Bashitha07/Multi-Stage-Analog-Signal-Conditioner/AE Photos/Full circuit/1.jpeg

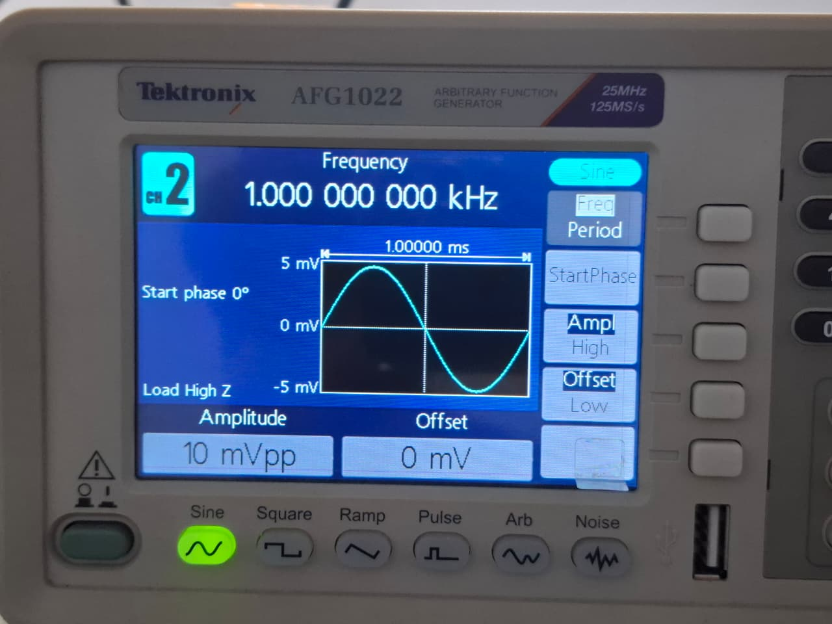
AE Photos/Full circuit/1.jpeg
