Bashitha07/Multi-Stage-Analog-Signal-Conditioner/README.md

# Multi-Stage Analog Signal Conditioner

Analog signal conditioning circuit designed to isolate a 2 kHz to 12 kHz audio passband and amplify weak signals using a BC547 NPN transistor amplifier stage.

## Overview

This project implements a multi-stage analog filter and amplifier to:
- Isolate an audio passband from 2 kHz to 12 kHz (bandpass filtering).
- Amplify low-level signals using a BC547 BJT amplifier stage.
- Validate the design using Proteus simulation files and measured results.

## Features

- Bandpass filtering to suppress low-frequency noise and high-frequency interference.
- BJT amplification stage (BC547) for signal gain.
- Proteus simulation project (.pdsprj) for circuit simulation and frequency response analysis.
- Project report with design calculations and circuit photos.

## Repository structure

```text
├── AE Photos/                                   # Circuit schematics and setup photos
├── AE_Final.pdsprj                              # Proteus design file (simulation project)
├── Group No. 04 - AE - Final Assignment Report.pdf  # Detailed design & calculations report
└── README.md                                    # Project documentation
```

## 👥 Project Team

**Module:** IE2034 – Analog Electronics  
**Academic Year:** Year 2, Semester 2  
**Institution:** Sri Lanka Institute of Information Technology (SLIIT)  
**Group:** 04

| Student | Student ID |
|---|---|
| Sellapperuma B.A. | IT24103485 |
| Jayasinghe L.P. | IT24100888 |
