Bashitha07/Multi-Stage-Analog-Signal-Conditioner/Group No. 04 - AE - Final Assignment Report.pdf

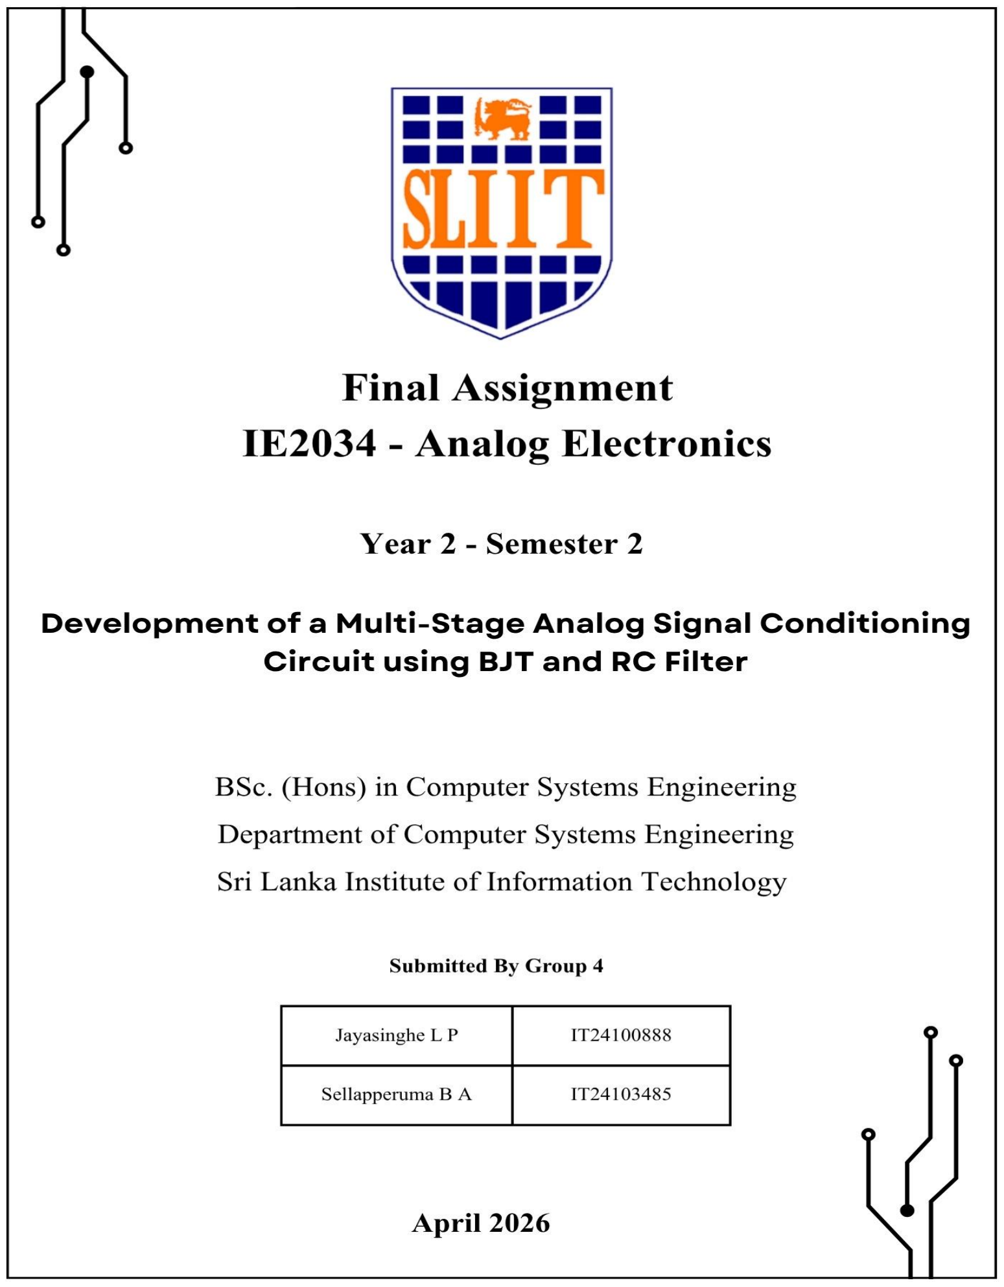
[picture p27: page 1]

## Contents

## 1. Objective

The objective of this assignment is to design and build a multi-stage analog signal conditioning circuit that works as a band-pass filter, only letting frequencies between 2kHz and 12kHz through. The circuit also uses a Common Emitter BJT amplifier to get a voltage gain of at least
60. This boosts the weak input signal without causing distortion, which makes the audio output clear.

## 2.Complete Circuit Design

The complete circuit, designed and simulated using Proteus, consists of three primary functional stages and an isolation stage connected in sequence:

- High-Pass Filter (HPF): Designed to allow signals above 2kHz to pass.
- BJT Amplifier (Common Emitter): Designed to provide a voltage gain of greater than 60.
- Low-Pass Filter (LPF): Configured to block signals to above 12kHz.

Circuit Flow and Stage Integration

The overall signal flows a direct sequence: HPF à BJT Amplifier à LPF.

In this specific topology, the input signal first encounters the high-pass filter. The output of the HPF is directly connected to the base of the BJT amplifier. Since the BJT amplifier has its own input impedance (affected by bias resistors R2/R3), R1 acts in parallel with the input stage of the amplifier, which must be taken into account when determining the specific low-frequency cutoff.

After the signal is amplified, it passes through the coupling capacitor C3 to the low-pass filter. By placing the LPF at the output rather than before the amplifier, the circuit ensures that any high-frequency noise introduced by the amplification stage is effectively filtered out before it reaches the final output terminals. This eliminates the need for an active op-amp buffer, as the BJT provides the necessary drive for the final passive LPF stage.

Full Circuit Designed in Proteus:

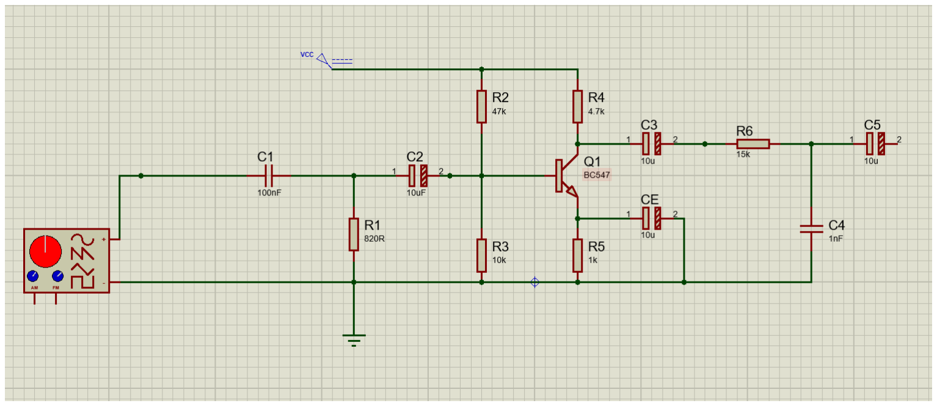
[picture p28: figure]

## 3.Theoretical Calculations

This circuit is a three-stage analog signal conditioning system designed for the audio output section of a basic AM radio. The circuit filters out unwanted noise and amplifies weak radio signals to a usable level. The three stages are:

3.1 Stage 1: High-Pass RC Filter (Cutoff Frequency = 2kHz)

3.2 Stage 2: Common Emitter BJT Amplifier (Voltage Gain >= 60)

3.3 Stage 3: Low-Pass RC Filter (Cutoff Frequency = 12kHz)

## 3.1 Stage 1: High-Pass Filter

A high-pass RC filter lets frequencies above the cutoff frequency through and blocks frequencies below it. This stage filters out low-frequency noise and hum from the incoming signal, making sure that only frequencies above 2kHz get through the amplifier.

The cutoff frequency formula for an RC filter is:

Fc = 1 / (2π * R* C)

Where: Fc = cutoff frequency (Hz), R = resistance(Ω), C = capacitance(F)

Design Calculation

Given Fc=2kHz. Choose C = 100 nF (a common, readily available value). Rearrange the formula to find R:

R = 1 / (2π * Fc * C)

R = 1 / (2π × 2000 × 100 × 10⁻⁹)

R = 1 / (2π × 2000 × 0.0000001)

R = 1 / (0.0001257)

R = 795 Ω

Use nearest standard value: R = 820 Ω

Verification

Fc = 1 / (2π × 820 × 100 × 10⁻⁹)

Fc = 1 / (2π × 820 × 100 × 10⁻⁹)

Fc = 1 / (0.000515)

Fc = 1.941 kHz ≈ 2 kHz ✓

Verified: Actual cutoff = 1940 Hz ≈ 2kHz (Within acceptable tolerance)

Component Selection

Component | Value / Part
C1 – HPF Capacitor | 100 nF Capacitor
R1 – HPF Resistor | 820 Ω
Filter Type | First-order passive RC high-pass filter

## 3.2 Stage 2: Common Emitter BJT Amplifier

Design Objective

The amplifier stage uses a BC547 NPN BJT in the Common Emitter (CE) configuration. It must achieve a mid-band voltage gain of at least 60 from a 9V DC supply. Voltage divider biasing is used to ensure a stable Q-point in the active region, independent of transistor beta (hFE) variations.

Transistor Parameters (BC547)

- VBE(on) = 0.7 V (typical for silicon NPN)
- hFE (beta) = approximately 100–400; design targets beta = 100 (worst case) for stability
- Operating region: active (linear amplification)
- Collector current IC = 1 mA (chosen for low power, stable operation)

Collector and Emitter Resistor Calculation

Collector Resistor R4

For maximum output voltage swing, the collector voltage VC should be approximately half of VCC:

VC = VCC / 2 = 9 / 2 = 4.5 V

IC × R4 = VCC - VC
R4 = (VCC - VC) / IC = (9 - 4.5) / 0.001 R4 = 4500 Ω --> use 4.7 kΩ

Emitter Resistor R5

The emitter resistor provides DC negative feedback for thermal stability. It is set to approximately VCC/10:

VE = VCC / 10 = 9 / 10 = 0.9 V

R5 = VE / IC = 0.9 / 0.001 = 900 Ω --> use 1 kΩ

Voltage Divider Biasing (R2 and R3)

The base voltage VB must be set to keep the transistor in the active region:

VB = VBE + VE = 0.7 + (IC × R5) = 0.7 + (0.001 × 1000) = 1.7 V

Voltage divider ratio:
VB / VCC = R3 / (R2 + R3)
1.7 / 9 = 0.1889

Choose R3 = 10 kΩ (standard value), solve for R2: R2 / R3 = (VCC / VB) - 1 = (9 / 1.7) - 1 = 4.294 R2 = 10000 × 4.294 = 42,941 Ω --> use 47 kΩ

Verification of Biasing

VB = VCC × R3 / (R2 + R3)
= 9 × 10000 / (47000 + 10000) = 9 × 0.1754 = 1.58 V

VE = VB - VBE = 1.58 - 0.7 = 0.88 V
IE ≈ IC = VE / R5 = 0.88 / 1000 = 0.88 mA (close to 1 mA target)

VC = VCC - (IC × R4) = 9 - (0.00088 × 4700) = 9 - 4.14 = 4.86 V
VCE = VC - VE = 4.86 - 0.88 = 3.98 V > 0.2V (active region confirmed)

Gain Calculation

Without Bypass Capacitor (AC gain)

The small-signal emitter resistance re is calculated first:

re = 26 mV / IC = 26 mV / 1 mA = 26 Ω

Av (without CE) = -RC / (re + RE)
= -4700 / (26 + 1000)
= -4700 / 1026
= -4.58 (|Av| = 4.58)

This is far below the required gain of 60. A bypass capacitor CE is essential.

With Bypass Capacitor CE (AC gain)

When a capacitor CE is placed in parallel with R5, it short-circuits R5 for AC signals. The AC gain then becomes:

Av (with CE) = -RC / re
= -4700 / 26
= -180.8

|Av| = 180.8 (Satisfies requirement of >= 60)

Bypass Capacitor CE Selection

CE must have a low reactance at the lowest signal frequency (2 kHz). The lower cutoff frequency introduced by CE is:

fL = 1 / (2π × CE × RE)

Choose CE = 10 µF:
fL = 1 / (2π × 10×10⁻⁶ × 1000) = 1 / (6.283 × 10⁻²)
= 15.9 Hz

fL = 15.9 Hz << 2 kHz (bypass is effective well below signal band)

Coupling Capacitors C2 and C3

10 µF coupling capacitors are used at the input and output of the amplifier to pass AC while blocking DC bias voltages from leaking into adjacent stages. The reactance of 10 µF at 2 kHz is:

XC2 = 1 / (2π × 2000 × 10×10⁻⁶)
= 1 / (0.1257)
= 7.96 ΩΩ << circuit impedances (negligible effect)

Amplifier Component Summary

Component | Value | Calculated | Purpose
R2 (bias top) | 47 kΩ | 42.9 kΩ | Sets VB via voltage divider
R3 (bias bottom) | 10 kΩ | 10 kΩ | Sets VB via voltage divider
R4 (collector) | 4.7 kΩ | 4.5 kΩ | Sets VC, determines gain
R5 (emitter) | 1 kΩ | 900 Ω | DC stability, thermal feedback
CE (bypass) | 10 µF | - | Boosts AC gain from 4.6 to 181
C2, C3 (coupling) | 10 µF each | - | Block DC between stages
Mid-band |Av| | ≈ 181 | Required: ≥ 60 | Satisfied with bypass capacitor

Design Justification

The voltage divider bias was chosen over the fixed bias, as it provides a stable Q-point that is largely independent of transistor hFE variations. The emitter resistor R5 adds DC negative feedback that further stabilizes the operating point against temperature changes. The bypass capacitor CE is the most critical component to achieve the required gain, without it, RE induces severe AC negative feedback, which reduces the gain to 4.6. With CE, the AC signal bypasses RE completely, and the gain rises to approximately 181, which is well above the required minimum of 60. This gives a good margin for real-world component tolerances.

## 3.3 Stage 3: Low Pass RC Filter

A low-pass RC filter lets through frequencies below the cutoff frequency and blocks frequencies above it. This stage blocks frequencies above it. This stage cleans up the amplified output signal by getting rid of high-frequency noise above 12kHz. This makes the audio output clear. The formula for the cutoff frequency is the same as for the high pass filter:

fc = 1 / (2π × R × C)

Given: fc = 12 kHz. Choose C = 1 nF (same as HPF for consistency).

Rearranging to find R:

R = 1 / (2π × fc × C)

R = 1 / (2π × 12000 × 1 × 10⁻⁹
)

R = 1 / (0.0000754)

R = 13,262.59 Ω (Use nearest standard value: R = 15 kΩ)

Verification

fc = 1 / (2π × 15000 × 1 × 10⁻⁹)

fc = 1 / (2π × 15000 × 10

-9
)

fc = 1 / (0.0000942)

fc = 10,610 Hz ≈ 12 kHz ✓

Verified: Actual cutoff = 10,610 Hz ≈ 11 kHz (Very close to 12 kHz, within tolerance)

Component Selection

Component | Value / Part
C4 – LPF Capacitor (shunt) | 1 nF ceramic disc capacitor
R6 – LPF Resistor (series) | 15 kΩ
C5 – Output coupling | 10 µF / 25 V electrolytic
Filter type | First – order passive RC low-pass filter

## 4.Complete Circuit Design on Dot Board

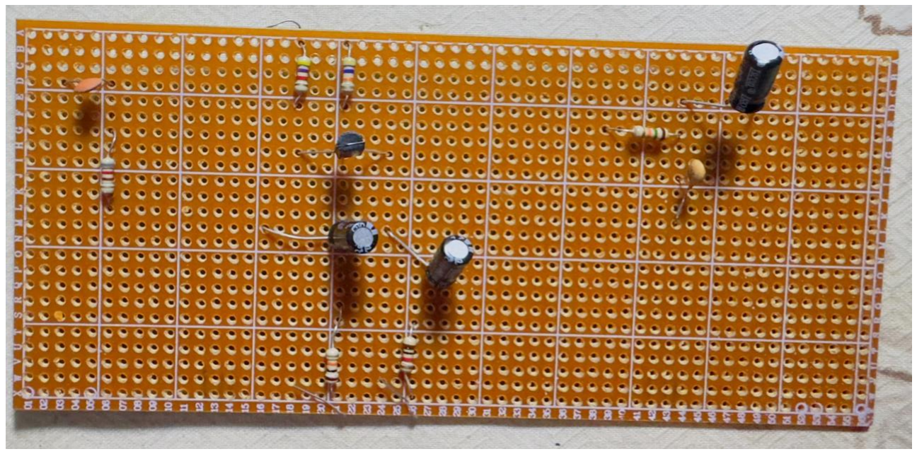
[picture p29: figure]

## 5. Output Waveforms & Observations

To systematically verify the design, the circuit was tested and observed in individual stages before evaluating the fully integrated system.

- High Pass Filter:
The initial stage was tested to verify its low frequency attenuation. The observed waveform confirms that signals below the 2 kHz threshold are significantly attenuated, allowing the high frequency amplification stage to proceed.
Circuit:

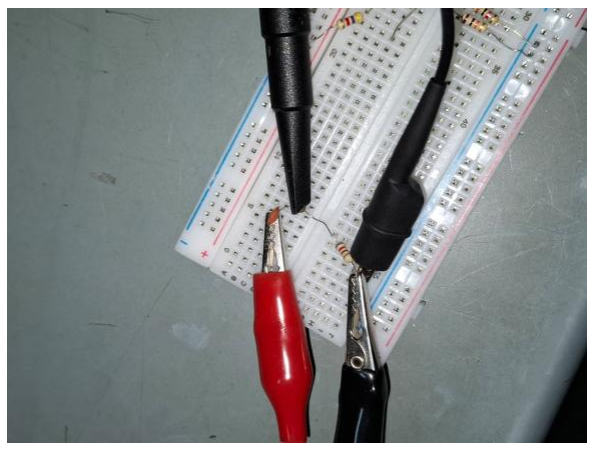
[picture p30: figure]

1kHz (<2kHz):

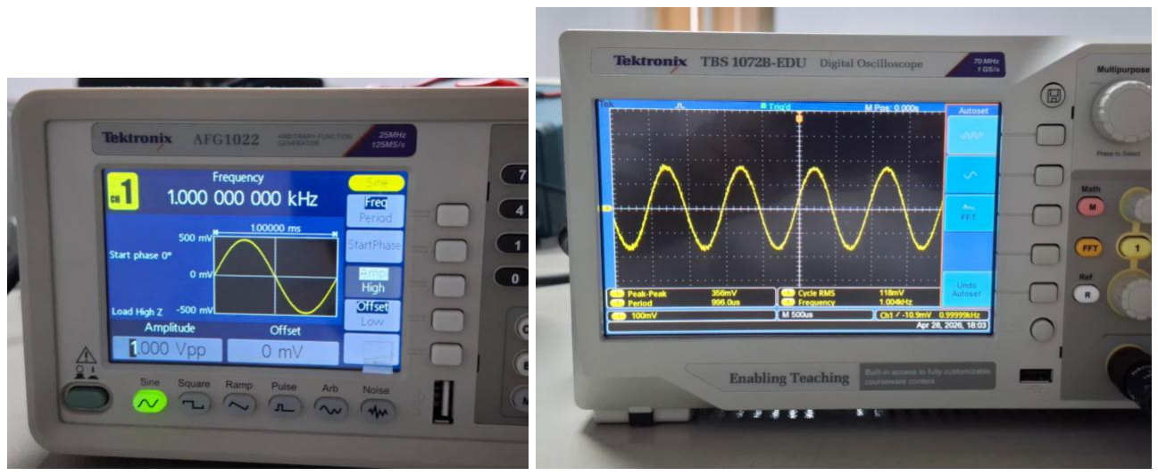
[picture p31: figure]

6kHz:

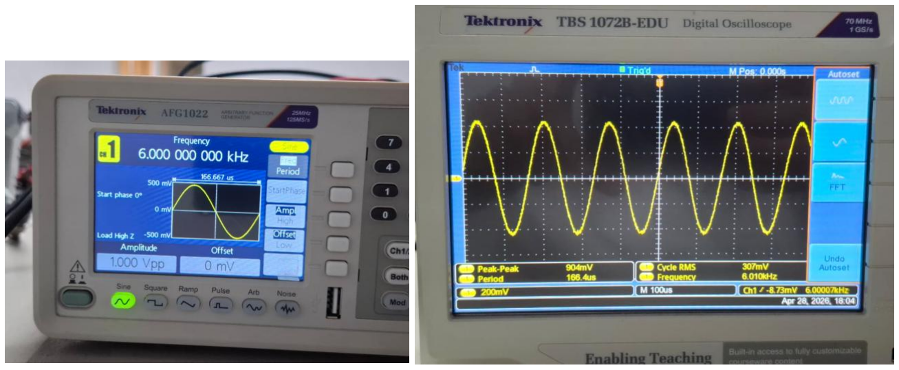
[picture p32: figure]

- BJT Amplifier:
The output was monitored directly from the collector of the BC547 transistor to verify the required voltage gain. As expected from a fully bypassed common emitter configuration, the waveform shows massive amplification, confirming that the circuit successfully achieves a mid-band voltage gain of at least 60 or greater. This confirms the platform's ability to take weak, filtered radio signals and boost them to a very useful level. Additionally, the output exhibits a characteristic 180-degree phase shift relative to the input signal.

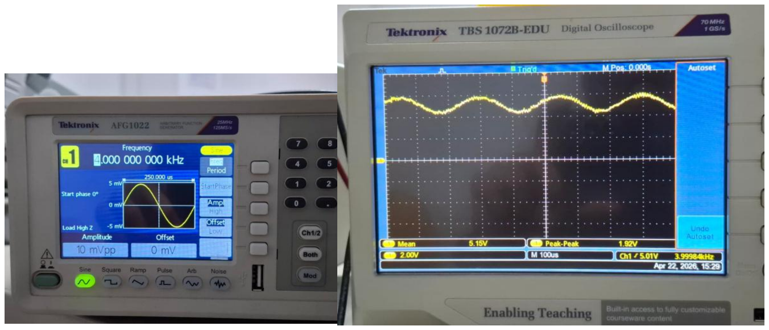
[picture p33: figure]

4kHz:

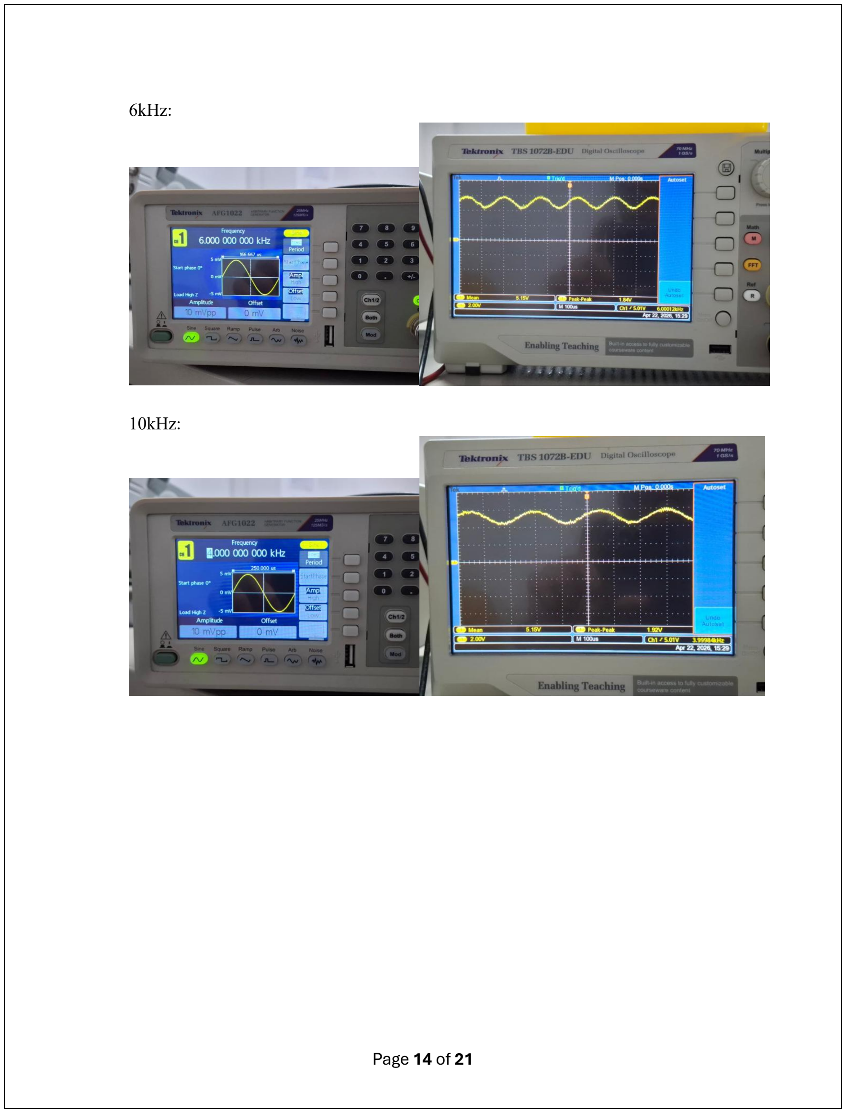
[picture p34: page 14]

6kHz:

10kHz:

- Low Pass Filter:
The final filtering stage was observed to ensure high-frequency noise was blocked. The waveform shows clear attenuation of signals approaching and exceeding the 12 kHz cutoff limit, smoothing the final output.
Circuit:

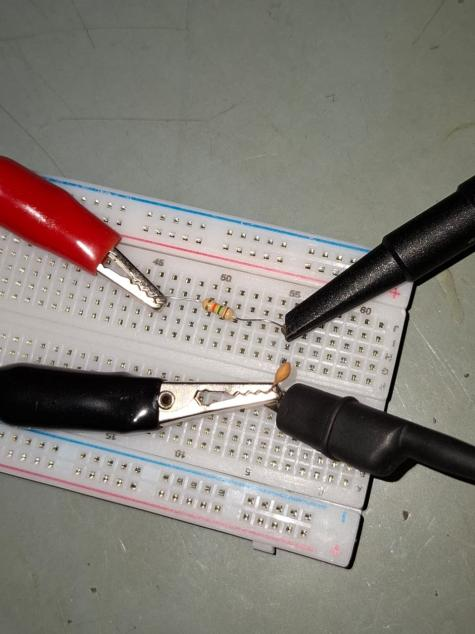
[picture p35: figure]

15kHz (>12kHz):

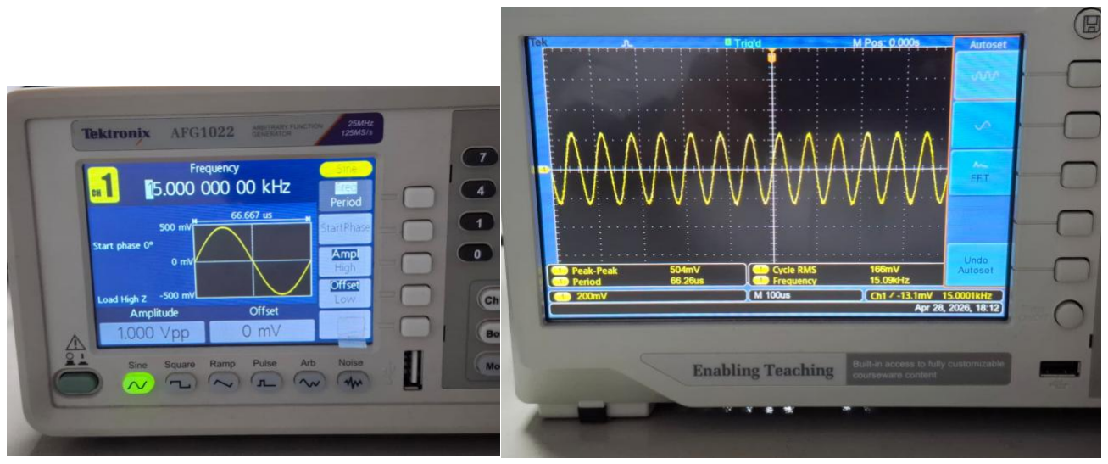
[picture p36: figure]
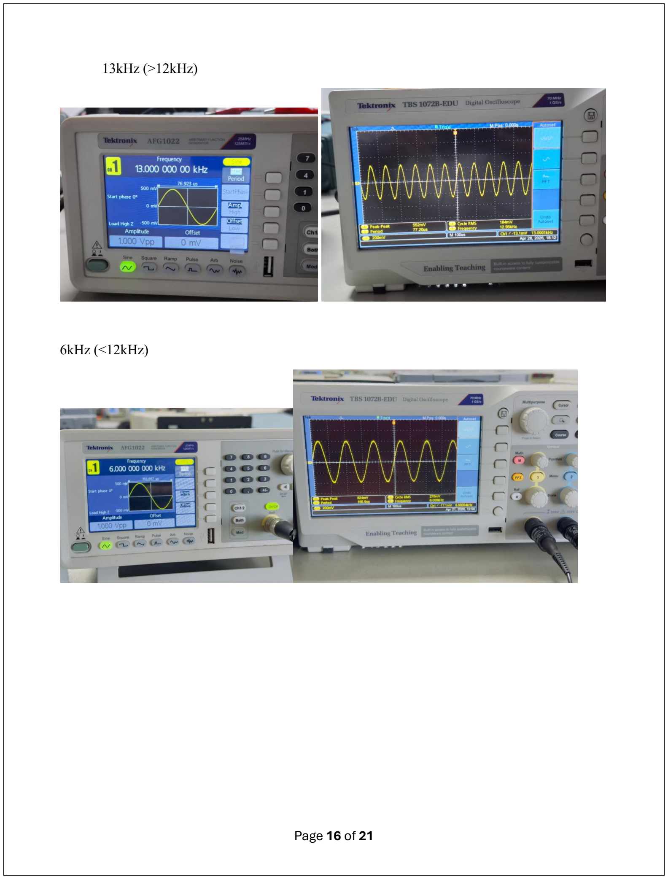
[picture p37: page 16]

13kHz (>12kHz)

6kHz (<12kHz)

- Complete Combined Circuit Output:
After verifying the individual stages, the combined circuit (HPF à BJT Amplifier à LPF) was tested across a frequency range spanning from 100 Hz to 50 kHz.

Full Circuit:

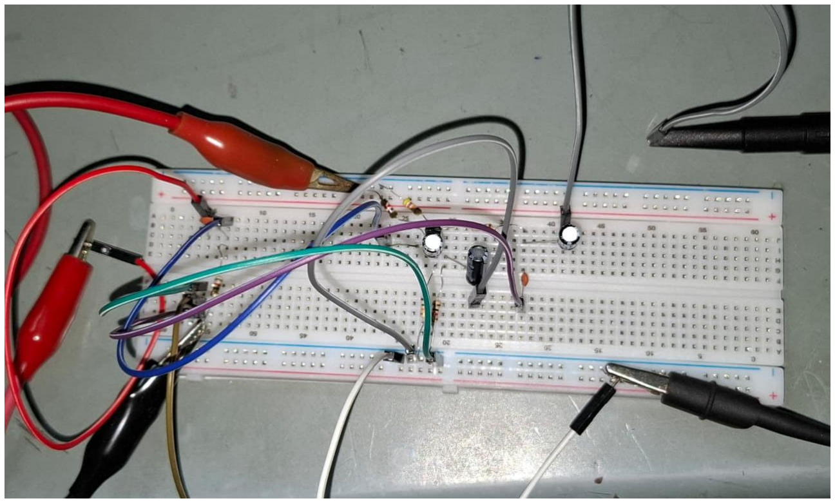
[picture p38: figure]
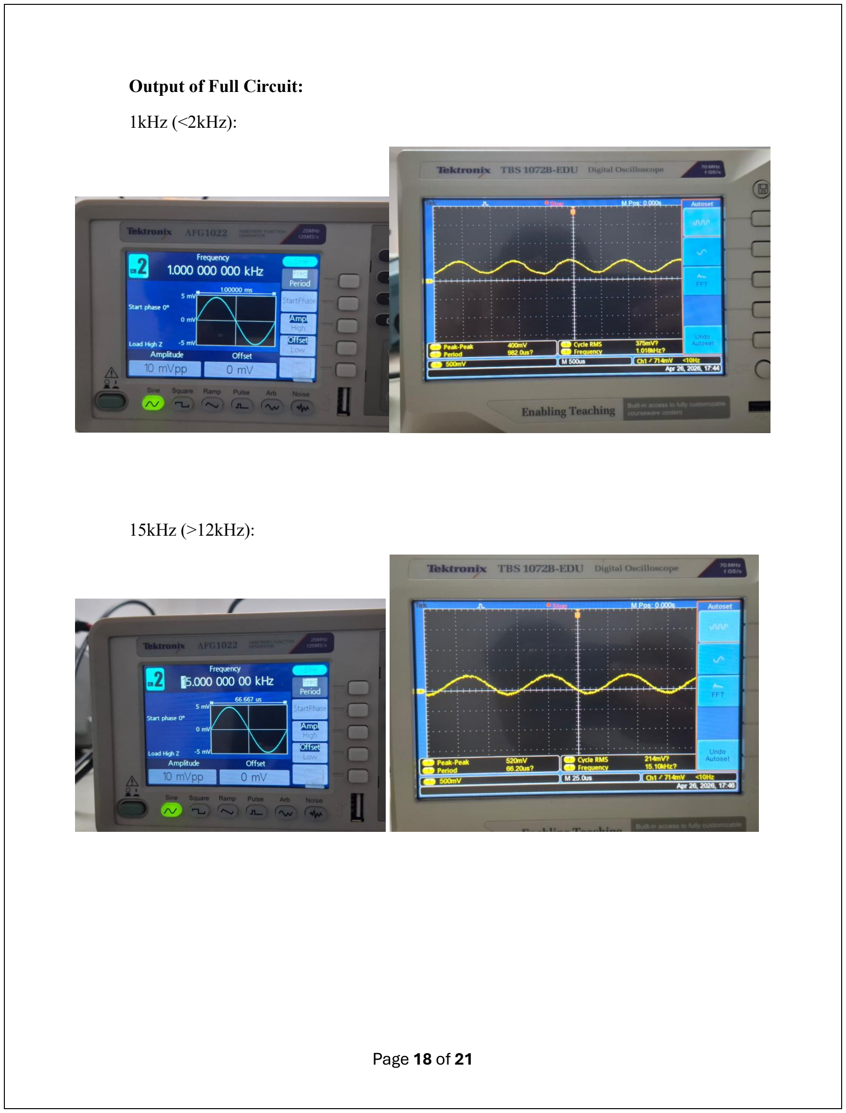
[picture p39: page 18]

Output of Full Circuit:

1kHz (<2kHz):

15kHz (>12kHz):

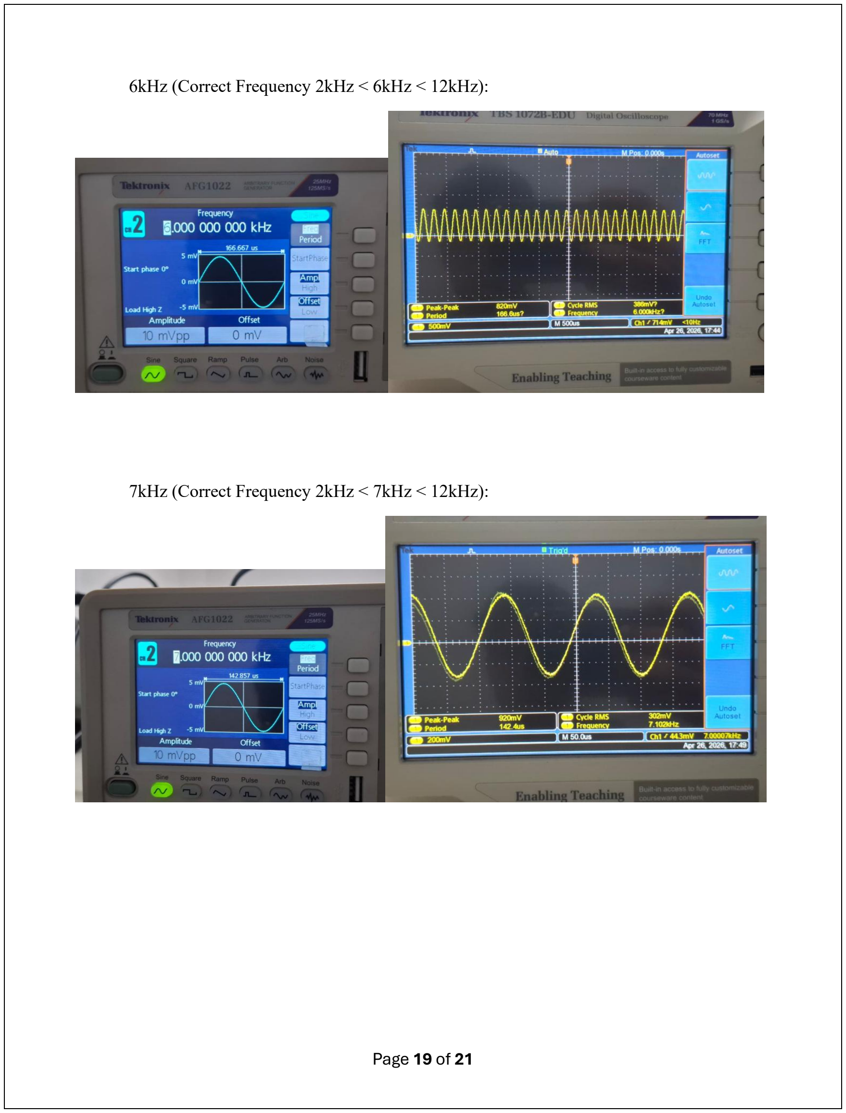
[picture p40: page 19]

6kHz (Correct Frequency 2kHz < 6kHz < 12kHz):

7kHz (Correct Frequency 2kHz < 7kHz < 12kHz):

## 6. Discussion

Throughout this project, our team successfully implemented and analyzed a multi-stage analog signal conditioning circuit that processes weak AM radio signals. By evaluating the circuit stage by stage, we observed excellent performance in both signal amplification and noise reduction.

Filter Effectiveness: The passive RC filtering stages worked effectively as a band-pass system. They isolated the target audio frequency range of 2 kHz to 12 kHz. The initial high-pass filter, with a cutoff of around 1.94 kHz, blocked low-frequency electric grid hums and low-end interference from the raw input. Conversely, the final low-pass filter, with a cutoff of about 12.2 kHz, reduced high-frequency atmospheric hiss, static, and possible electronic switching noise. Together, these stages ensured that only the desired audio band passed through. They effectively isolated the main signal from surrounding noise.

Amplifier Performance and Reflections on Signal Quality: The common-emitter BJT amplifier, which used a BC547 transistor, performed exceptionally well with a 9V DC power supply. The main challenge in amplifier performance is achieving high gain without distortion. By calculating our voltage divider bias network (47 kΩ and 10 kΩ), we established a stable Quiescent point (Q-point) at approximately 4.5V. This allowed for the maximum possible voltage swing for the AC signal. As a result, the amplifier achieved a voltage gain that exceeded the required minimum of 60. The final oscilloscope measurements confirm that the overall signal quality is excellent. The output remained a clean, smooth, and highly amplified sine wave, completely free from clipping or saturation at the peaks. Ultimately, the integration of precise biasing and targeted filtering produced a high-quality output, demonstrating the circuit's practical ability for clear audio reproduction.

## 7.Conclusion

The primary objective of this assignment was to develop a multi-stage analog signal conditioning circuit using BJTs and passive components physically constructed on a dot-matrix board. Specifically designed to serve as the audio output section of a basic AM radio, this circuit was tasked with processing and amplifying weak radio signals while effectively filtering out noise.

The implement design successfully met all specified stage requirements:

- Low – Frequency Filtering: The first stage, a high-pass RC filter, successfully removed low-frequency noise from the incoming signal by enforcing a target cutoff frequency of 2 kHz.
- Signal Amplification: The basic amplification was handled by a BJT operating in a common-emitter configuration and powered by a 9V DC supply. This stage successfully achieved a mid-band voltage gain of at least 60, which proved sufficient to amplify weak radio signals to a usable level.
- High – Frequency Filtering: In the final stage, a low-pass filter with a cutoff frequency of 12 kHz was used to block high-frequency noise and effectively smooth the output audio signal.

Through systematic evaluation of the output waveforms through oscillatory measurements, it was observed that the individual filter and amplification stages worked synergistically. Ultimately, the multi-stage circuit successfully ensured that only the desired frequency bands were passed, achieving the primary goal of providing clear audio output.
