Bashitha07/Multi-Stage-Analog-Signal-Conditioner/AE Photos/BJT Filter/10 wave.jpeg

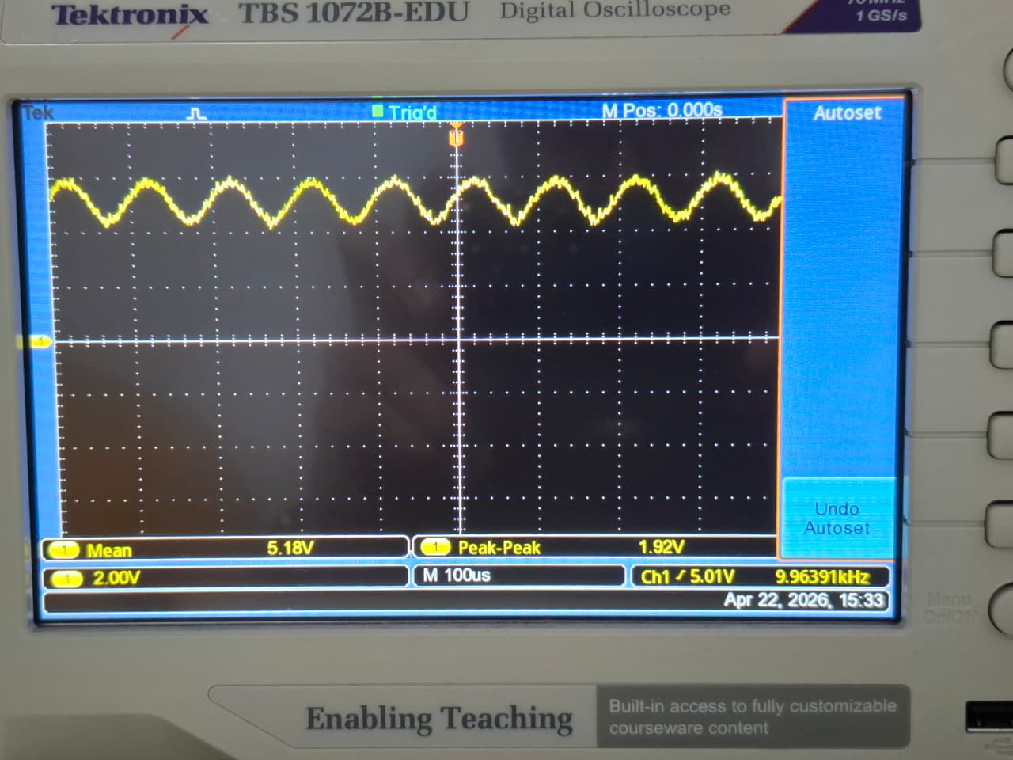
AE Photos/BJT Filter/10 wave.jpeg
