Bashitha07/Multi-Stage-Analog-Signal-Conditioner/AE Photos/Full circuit/7 wave.jpeg

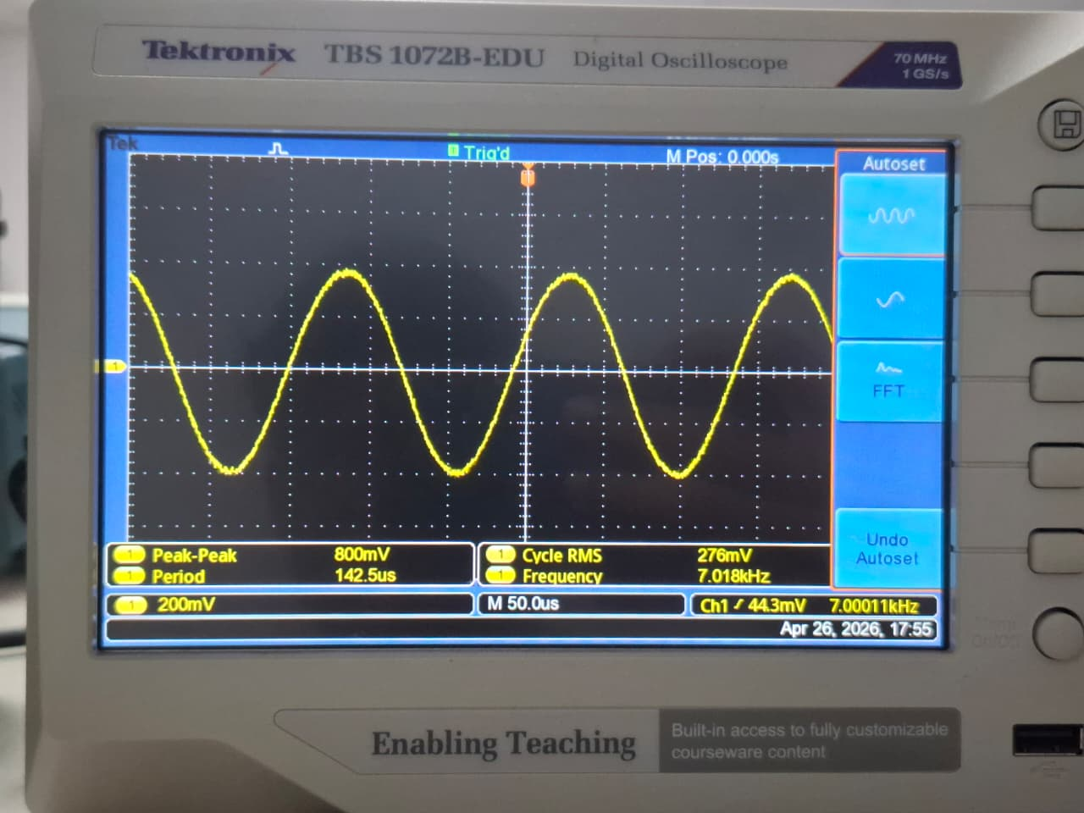
AE Photos/Full circuit/7 wave.jpeg
