Bashitha07/Multi-Stage-Analog-Signal-Conditioner/AE Photos/Full circuit/Circuit Simulation.png

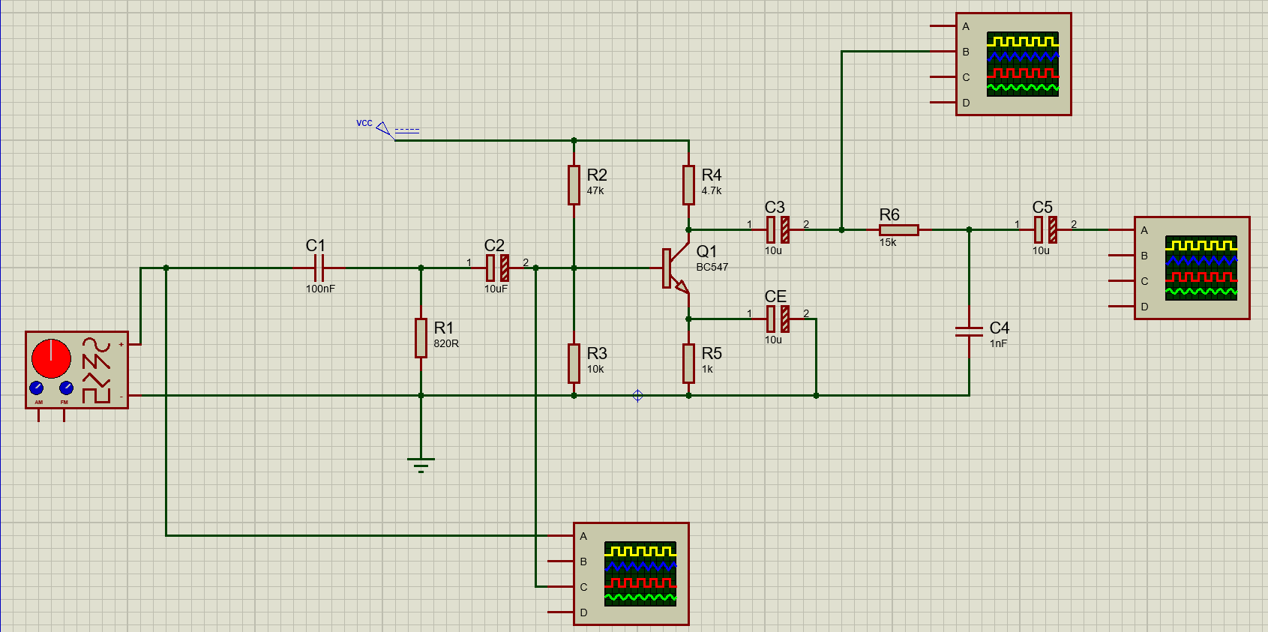
AE Photos/Full circuit/Circuit Simulation.png
