Bashitha07/Multi-Stage-Analog-Signal-Conditioner/AE Photos/Full circuit/Full Circuit.jpeg

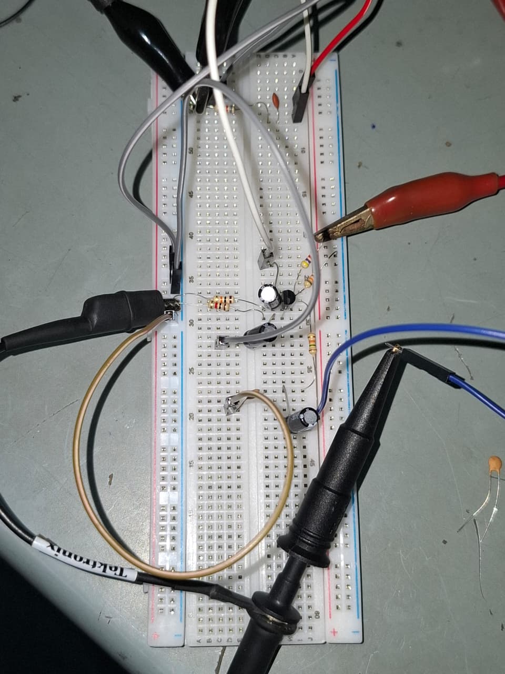
AE Photos/Full circuit/Full Circuit.jpeg
