Bashitha07/Multi-Stage-Analog-Signal-Conditioner/AE Photos/Highpass Filter/15 wave.jpeg

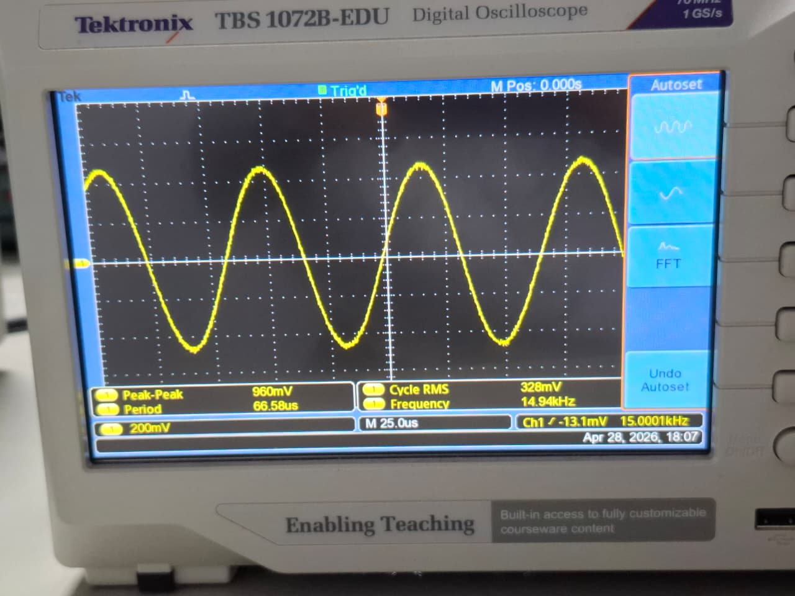
AE Photos/Highpass Filter/15 wave.jpeg
