Bashitha07/Multi-Stage-Analog-Signal-Conditioner/AE Photos/Highpass Filter/15.jpeg

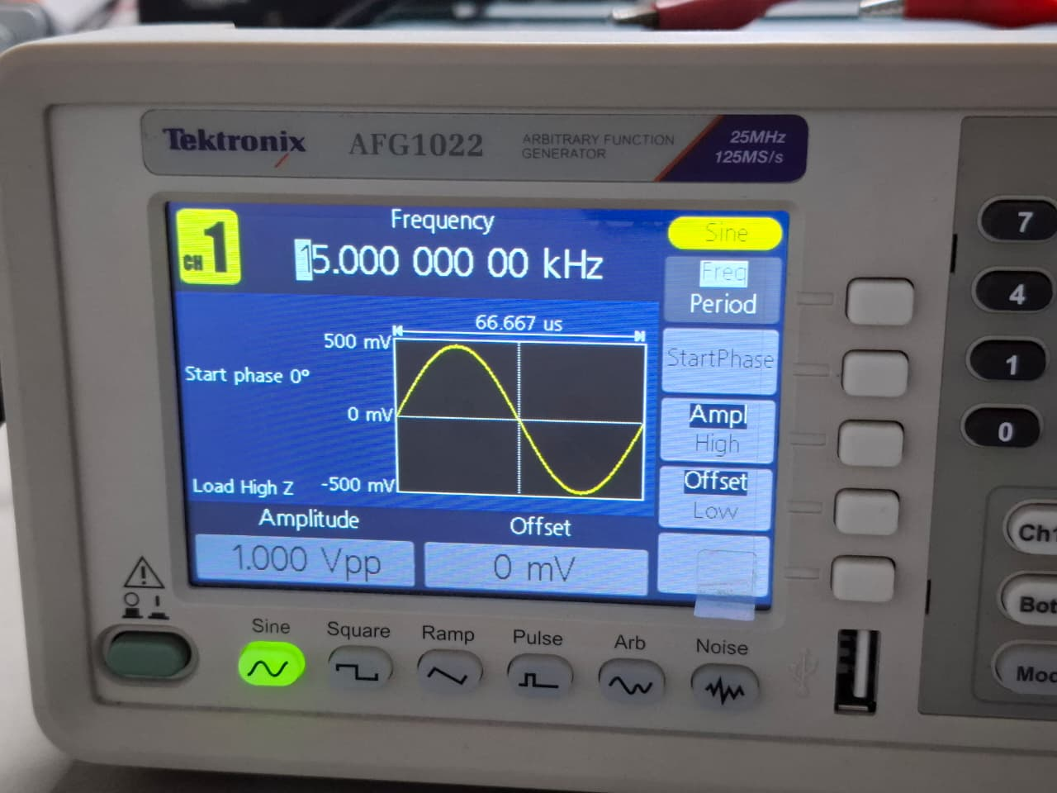
AE Photos/Highpass Filter/15.jpeg
