Bashitha07/Multi-Stage-Analog-Signal-Conditioner/AE Photos/Highpass Filter/High pass Circuit.jpeg

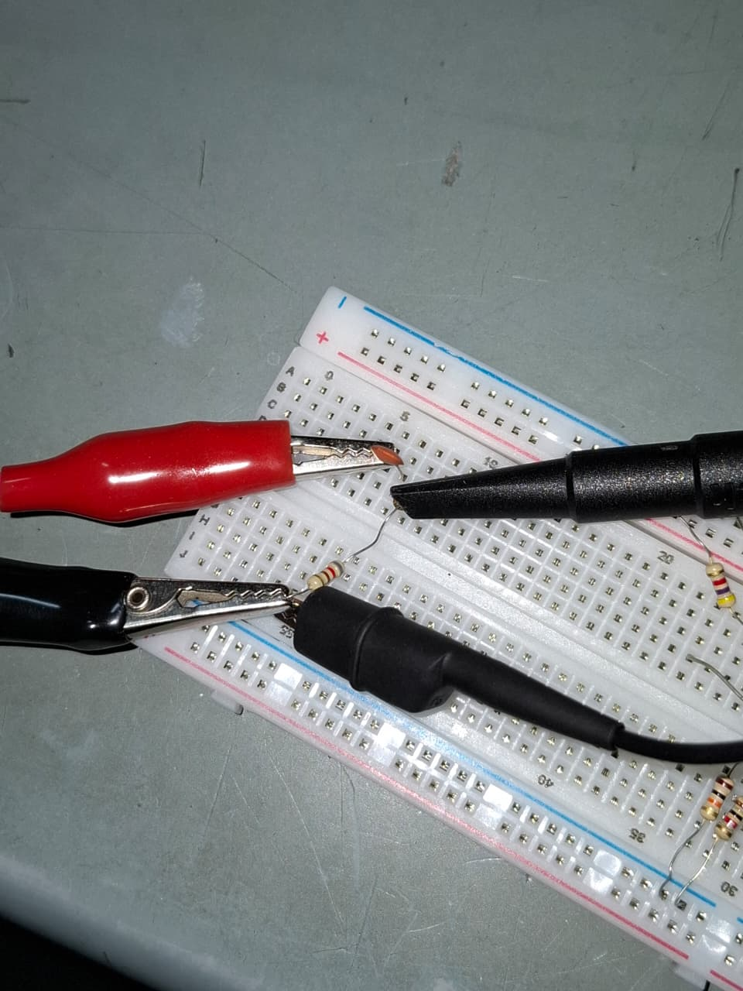
AE Photos/Highpass Filter/High pass Circuit.jpeg
