Bashitha07/Multi-Stage-Analog-Signal-Conditioner/AE Photos/Lowpass filter/6 wave.jpeg

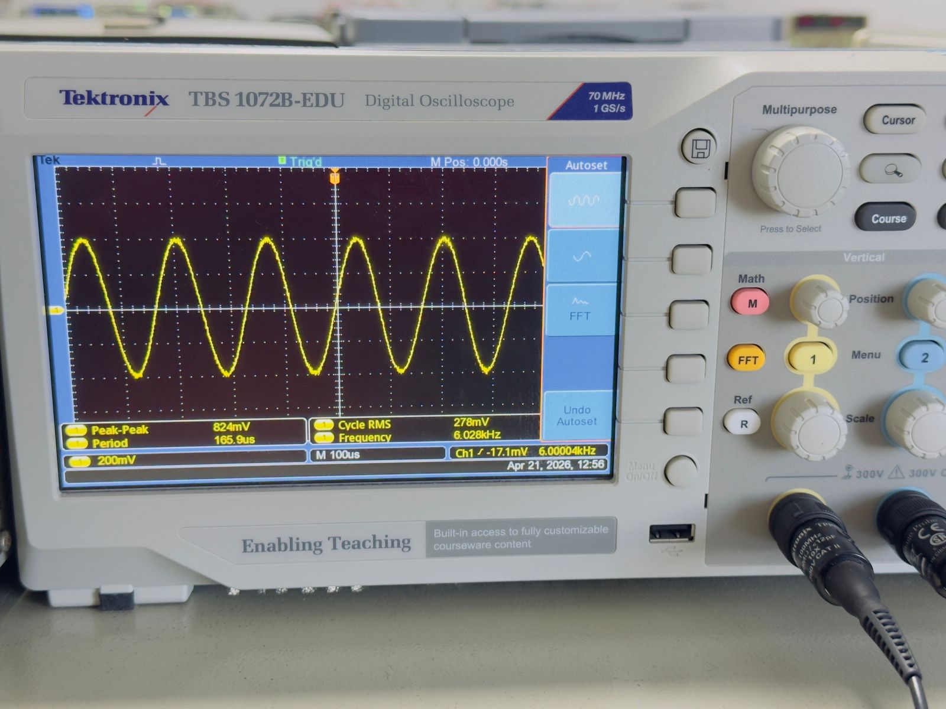
AE Photos/Lowpass filter/6 wave.jpeg
