Bashitha07/Multi-Stage-Analog-Signal-Conditioner/AE Photos/Lowpass filter/6.jpeg

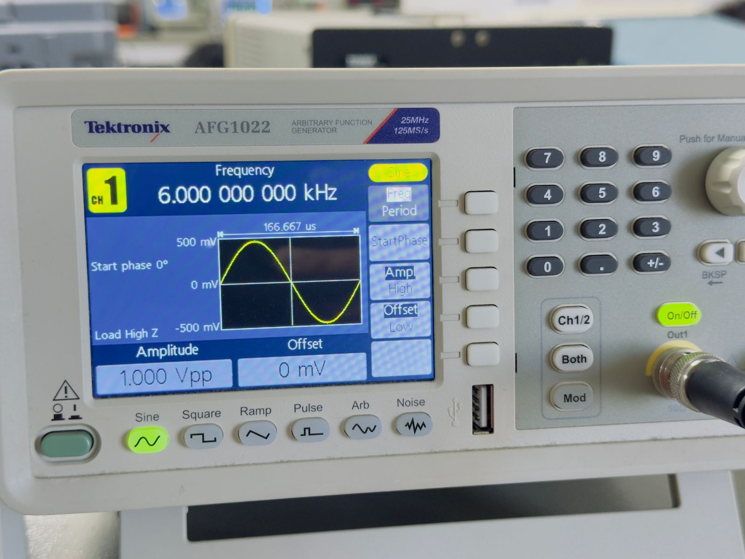
AE Photos/Lowpass filter/6.jpeg
