Bashitha07/Multi-Stage-Analog-Signal-Conditioner/AE Photos/Lowpass filter/20 wave.jpeg

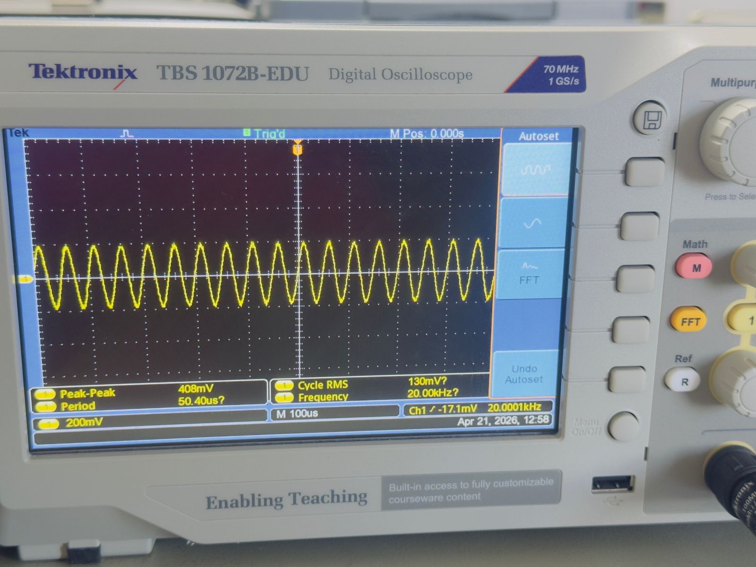
AE Photos/Lowpass filter/20 wave.jpeg
