Bashitha07/Multi-Stage-Analog-Signal-Conditioner/(list of files, drawings)

Other design files:
AE_Final.pdsprj
